aalhamad/irxbot/docs/spec/gearbox/Pasted image.png

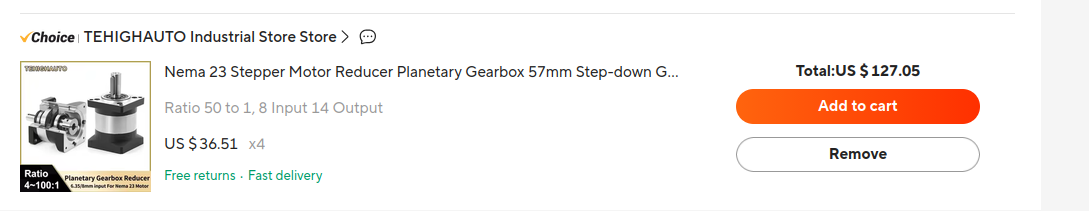
docs/spec/gearbox/Pasted image.png
