aalhamad/irxbot/docs/spec/motor-LK57BL9524/Screenshot from 2026-10-16 10-22-00.png

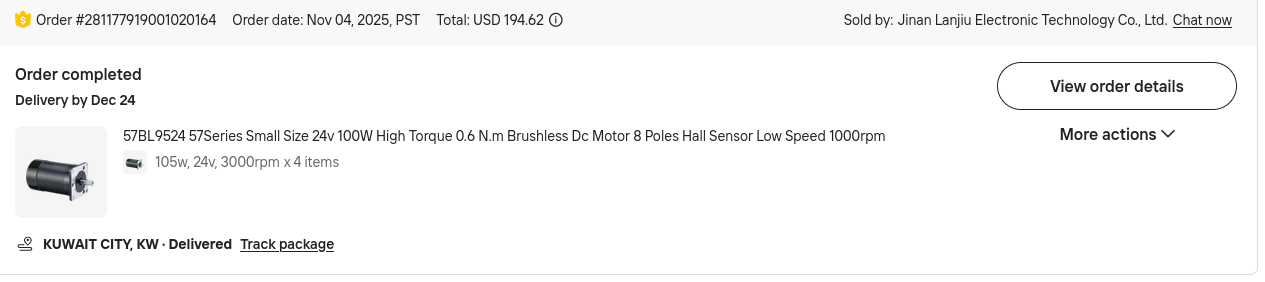
docs/spec/motor-LK57BL9524/Screenshot from 2026-10-16 10-22-00.png
