aalhamad/irxbot/docs/TODO.md

# IRXBot To-Do

## Now

See `docs/hardware-check-plan.md` for the plan and decisions.

### Hardware check and rewiring
- [ ] Compile and flash the `STATUS` firmware (see `docs/workflow.md`)
- [ ] Investigate the check results: invalid ToF readings, VEML7700 failed reads, high dust readings, LiDAR (see `docs/hardware-check-plan.md`)
- [x] ESP-IDF 5.3 is on the Jetson at `~/Apps/esp-idf` (capital A); the ESP32 is built and flashed there
- [ ] Run `scripts/robot_check.py --manual --baseline` and correct it from the first real output
- [ ] Before rewiring, run `robot_check.py --spin` with the wheels up and confirm all 4 wheels turn
- [ ] Check the Waveshare hub's input voltage on its label before powering it
- [ ] Temporary USB layout: Jetson = RealSense, STM32, ESP32, Waveshare hub. Waveshare hub = 4G modem, LiDAR, 360° camera, black 4-port hub. Black hub (unpowered, strap it down, all ports on) = ReSpeaker, thermal adapter
- [ ] When the second Waveshare hub arrives, it replaces the black hub: Waveshare hub 1 = ReSpeaker, 360° camera, LiDAR, hub 2. Hub 2 = thermal adapter, 4G modem
- [ ] Photograph and label the wires
- [ ] Rewire one section at a time, running the check after each: power, CAN, STM32 sensors, ESP32 sensors, USB

## Next

### SIM / 4G (Quectel EC25-EUX), after rewiring
- [ ] Fit SIM and antenna (`MAIN`, plus `DIV` if available)
- [ ] Connect modem to Jetson through the powered USB hub
- [ ] Turn on `ModemManager` and confirm the modem appears in `mmcli -L`
- [ ] Add rules so `ModemManager` ignores the STM32 and ESP32. **Do not drive while it is on without these**
- [ ] Set up the connection (needs carrier APN and SIM PIN status)
- [ ] Decide what it is for: remote access, Foxglove away from Wi-Fi, or internet only

### Audio
- [x] Confirm the ReSpeaker has a 3.5 mm output
- [x] Power the XH-M139 from the 12 V rail through a 5 A fuse, never the raw battery bus
- [x] Wire ReSpeaker to amp to speakers. Leave the subwoofer output empty and never connect a speaker `−` to ground
- [x] Run the record and playback tests on the Jetson (`plughw:ArrayUAC10,0`)
- [ ] Confirm both speakers play: run `speaker-test -D plughw:ArrayUAC10,0 -c 2 -t wav -l 2` and listen to each one
- [ ] Check for motor noise in the speakers and microphone while driving (the audio cable is unshielded)
- [ ] Mount the speakers and amp inside the robot
- [ ] Write the voice command software (none exists yet)

### Cameras
- [ ] 360° camera: connect it, get a picture, set `CAMERA_360_NAME` in `scripts/robot_check.py`
- [ ] Thermal camera: wire it through the USB-serial adapter, get a reading, confirm its data format

### ESP32
- [ ] Flash the LCD IP firmware and rebuild `ros2/` on the Jetson; confirm the LCD shows the IP and telemetry still arrives
- [ ] Install `scripts/irx-esp32-telemetry.service` so the IP shows at boot
- [ ] Reserve a fixed IP for the Jetson in the router
- [ ] Connect the native `USB` port (`303a:1001`) to the Jetson; leave the 5V pin and other USB port empty
- [ ] Power the LED strips from the 5 V rail, not through the ESP32 board
- [x] Set up fixed port names for the STM32 and ESP32 (the nodes find them in `/dev/serial/by-id/`)

### Close up the robot
- [ ] Tug-test the front left VESC CAN connector
- [ ] Strap down the USB cables
- [ ] Confirm the E-stop can be reached with the robot closed
- [ ] Check Wi-Fi signal with the robot closed (`nmcli device wifi list`, `SIGNAL` above about 50)

### Driving
- [ ] Measure the first drive against `/odom` (it reported 3.04 m forward, 0.94 m right): did it really veer?
- [ ] If it veers, find out why the front right wheel is slow to start
- [ ] Confirm the node's single `ERR:CMD_TIMEOUT` was left over from testing and does not repeat

## Later
- [ ] Publish IMU and ToF as ROS2 topics at proper rates (still every 3 s)
- [ ] Reinstall `sllidar_ros2` for the LiDAR
- [ ] Charger indicator with ATtiny
- [ ] Set up SLAM, then Nav2
- [ ] Foxglove for live data, then a custom dashboard if wanted (`docs/hardware-check-plan.md`)
- [ ] Resolve the ToF count: spec says 4 with a downward one, firmware has 5 with none
- [ ] Disable regen below 0 °C for outdoor use
- [ ] Delete `~/irx_fw_diag`, `~/irx_fw_build` (its .bin files were copied to `firmware/stm32/irx_drive/build/`) and `~/irx_test.log` on the Jetson

## Only if needed
- [ ] Wi-Fi upgrade if the signal is weak when closed: try external antennas on the built-in card first, then the AC1200 adapter (kept in the parts box, not in the spec)
