aalhamad/irxbot/docs/spec/motor-LK57BL9524/ZNF60-L2(12-100)14-50-70-M4.pdf

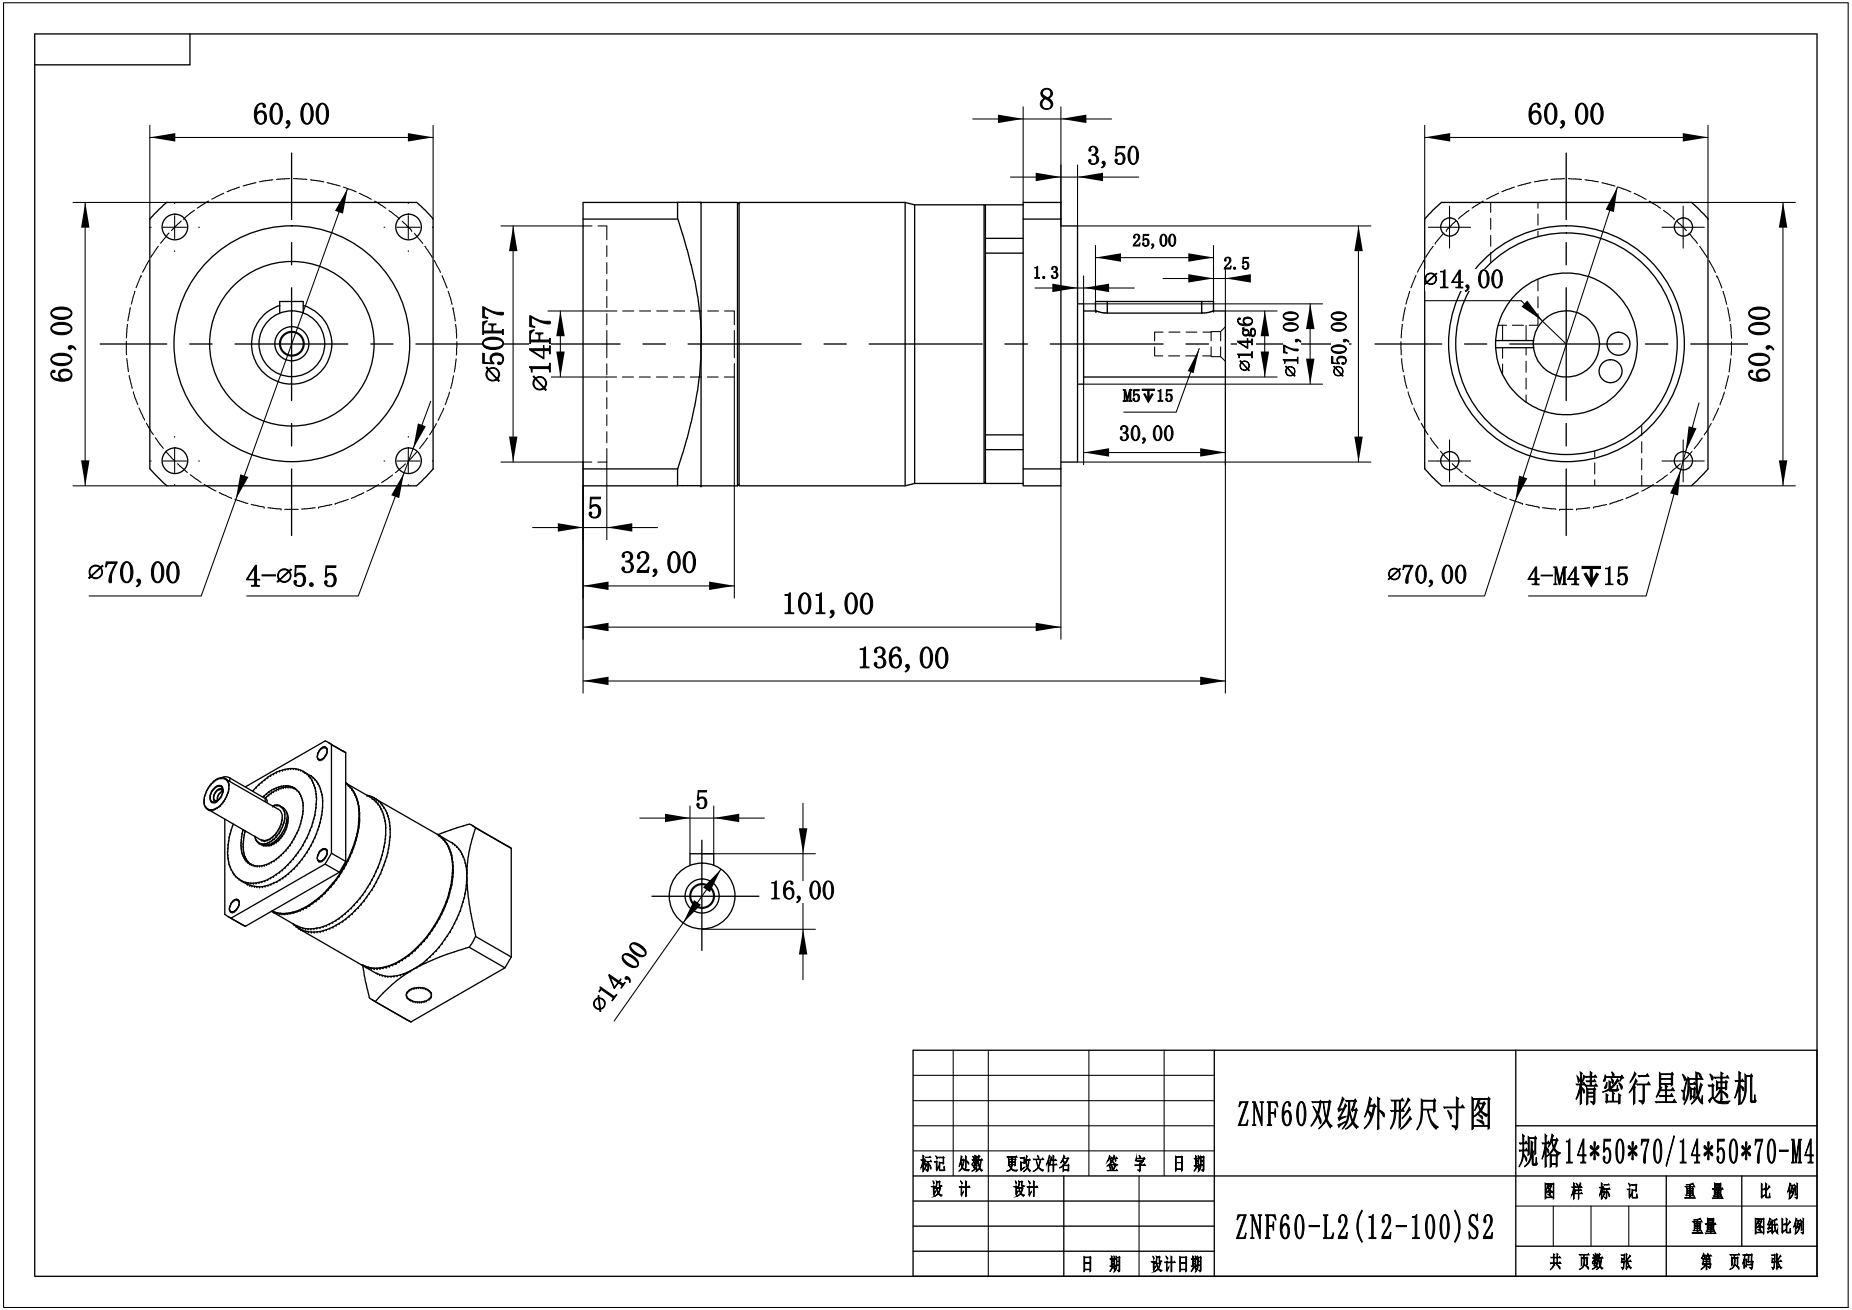
[picture p4: page 1]
