aalhamad/irxbot/docs/spec/motor-LK57BL9524/ZPF60-L2.pdf

型号:

Ø 7 0

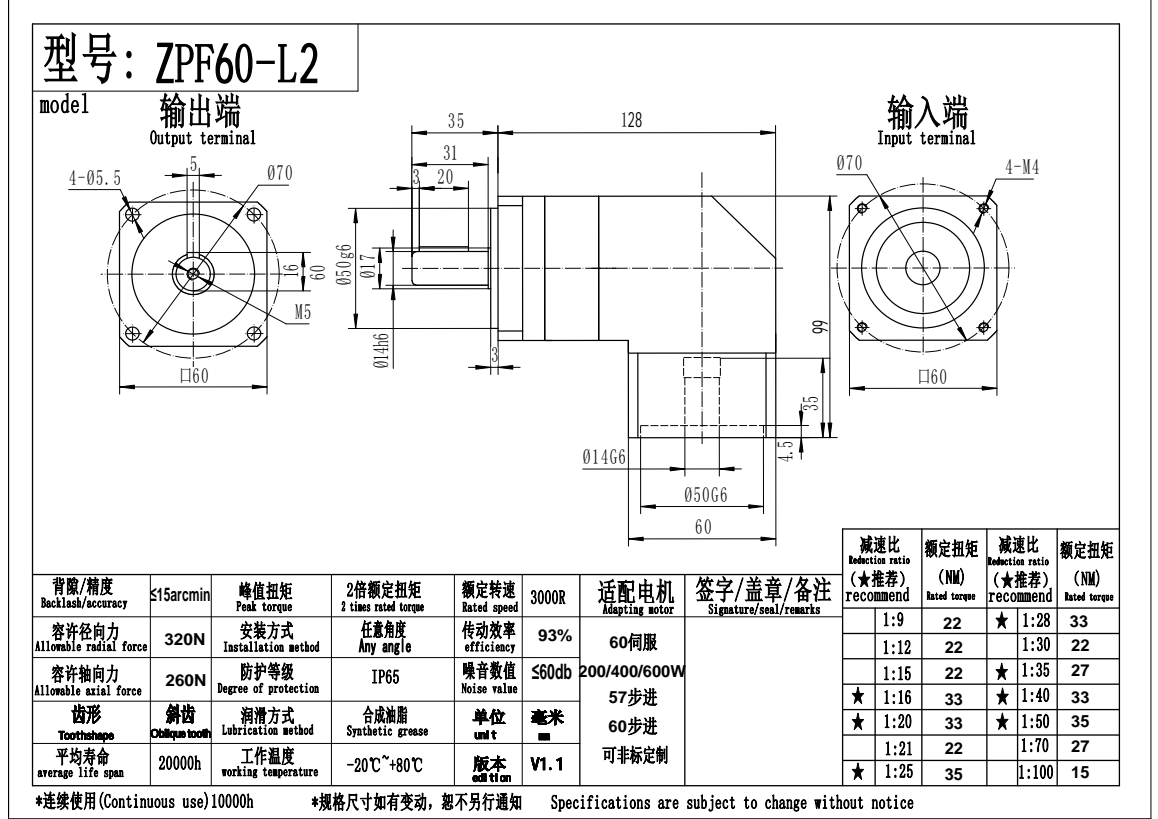
[picture p5: page 1]
ZPF60-L2; 输出端; 输入端

≤15arcmin | | 适配电机 | 签字/盖章/备注

22 | 33
22 | 22

320N | 93% | 60 200/400/600W 57 60
260N | | ≤60db | 22 | 27

33 | 33
33 | 35
22 | 27
35 | 15

齿形 齿形 齿形 齿形 齿形 Toothshape Toothshape Toothshape Toothshape Toothshape | 斜齿 斜齿 斜齿 斜齿 斜齿 Oblique tooth Oblique tooth Oblique tooth Oblique tooth Oblique tooth | 单位 单位 单位 单位 单位 unit unit unit unit unit | 毫米 毫米 毫米 毫米 毫米 mm mm mm mm mm

版本 版本 版本 版本 版本 edition edition edition edition edition | V1.1 V1.1 V1.1 V1.1 V1.1
