aalhamad/irxbot/firmware/stm32/irx_drive/Core/Src/main.c

	/* USER CODE BEGIN Header */
/**
  ******************************************************************************
  * @file           : main.c
  * @brief          : Main program body
  ******************************************************************************
  * @attention
  *
  * Copyright (c) 2026 STMicroelectronics.
  * All rights reserved.
  *
  * This software is licensed under terms that can be found in the LICENSE file
  * in the root directory of this software component.
  * If no LICENSE file comes with this software, it is provided AS-IS.
  *
  ******************************************************************************
  */
/* USER CODE END Header */
/* Includes ------------------------------------------------------------------*/
#include "main.h"

/* USER CODE BEGIN Includes */
#include "bno085.h"
#include "ibus.h"
#include "robot_drive.h"
#include "vl53l1x.h"
#include <stdio.h>
#include <string.h>
#include <stdlib.h>

/* USER CODE END Includes */

/* USER CODE BEGIN PD */
#define CMD_TIMEOUT_MS  1000U   /* stop if the Jetson sends no valid CMD for this long */
#define ODO_PERIOD_MS   50U     /* 20 Hz */
#define SPEED_PERIOD_MS 200U    /* 5 Hz to the ESP32 */

/* USER CODE END PD */

CAN_HandleTypeDef hcan1;

I2C_HandleTypeDef hi2c1;
I2C_HandleTypeDef hi2c2;

UART_HandleTypeDef huart1;
UART_HandleTypeDef huart2;
UART_HandleTypeDef huart3;

/* USER CODE BEGIN PV */
static uint32_t last_imu_tick     = 0;
static uint32_t last_tof_tick     = 0;
static uint32_t last_odo_tick     = 0;
static uint32_t last_speed_tick   = 0;
static uint32_t last_cmd_rx_tick  = 0;
static uint32_t last_err_tick[4]  = {0};
static uint8_t  cmd_buf[32];
static uint8_t  cmd_len           = 0;
static int32_t  cmd_left          = 0;
static int32_t  cmd_right         = 0;
static uint32_t last_cmd_tick     = 0;
static uint8_t  bumper_last       = 0xFF; /* force send on first loop */
static uint8_t  tof_reinit_count  = 0;
static uint32_t tof_reinit_tick   = 0;
static uint32_t horn_off_tick     = 0;  /* 0 = horn inactive */
static uint8_t  rc_override       = 0;

/* USER CODE END PV */

void SystemClock_Config(void);
static void MX_GPIO_Init(void);
static void MX_CAN1_Init(void);
static void MX_USART2_UART_Init(void);
static void MX_I2C1_Init(void);
static void MX_I2C2_Init(void);
static void MX_USART1_UART_Init(void);
static void MX_USART3_UART_Init(void);
/* USER CODE BEGIN 0 */

/* USART2 RX ring buffer: filled by USART2_IRQHandler, drained by the main loop.
 * The loop blocks on I2C for far longer than one byte time (87 us at 115200). */
#define UART2_RX_SIZE 256U   /* uint8_t indices wrap at exactly this size */

static volatile uint8_t uart2_rx[UART2_RX_SIZE];
static volatile uint8_t uart2_rx_head = 0;
static volatile uint8_t uart2_rx_tail = 0;
static volatile uint8_t uart2_rx_lost = 0;

void Uart2_RxByte(uint8_t b)
{
    uint8_t next = (uint8_t)(uart2_rx_head + 1U);
    if (next == uart2_rx_tail)
    {
        uart2_rx_lost = 1;   /* full: the line being received is now corrupt */
        return;
    }
    uart2_rx[uart2_rx_head] = b;
    uart2_rx_head = next;
}

static uint8_t Uart2_RxPop(uint8_t *b)
{
    if (uart2_rx_tail == uart2_rx_head) return 0;
    *b = uart2_rx[uart2_rx_tail];
    uart2_rx_tail = (uint8_t)(uart2_rx_tail + 1U);
    return 1;
}

/* Strict "<left> <right>" parse. A partial number must never become a speed. */
static uint8_t Parse_Cmd(const char *s, int32_t *left, int32_t *right)
{
    char *end;
    long l = strtol(s, &end, 10);
    if (end == s || *end != ' ') return 0;

    const char *r_start = end + 1;
    long r = strtol(r_start, &end, 10);
    if (end == r_start || *end != '\0') return 0;

    if (l < -6000 || l > 6000 || r < -6000 || r > 6000) return 0;

    *left  = (int32_t)l;
    *right = (int32_t)r;
    return 1;
}

/* USER CODE END 0 */

/**
  * @brief  The application entry point.
  * @retval int
  */
int main(void)
{

  /* MCU Configuration--------------------------------------------------------*/

  /* Reset of all peripherals, Initializes the Flash interface and the Systick. */
  HAL_Init();

  /* Configure the system clock */
  SystemClock_Config();

  /* Initialize all configured peripherals */
  MX_GPIO_Init();
  MX_CAN1_Init();
  MX_USART2_UART_Init();
  MX_I2C1_Init();
  MX_I2C2_Init();
  MX_USART1_UART_Init();
  MX_USART3_UART_Init();
  /* USER CODE BEGIN 2 */
  HAL_UART_Transmit(&huart2, (uint8_t*)"BOOT\r\n", 6, 100);

  if (vesc_can_start() != HAL_OK)
      HAL_UART_Transmit(&huart2, (uint8_t*)"ERR:CAN\r\n", 9, 100);
  else
      HAL_UART_Transmit(&huart2, (uint8_t*)"CAN_OK\r\n", 8, 100);

  /* IMU — hardware reset pulse so BNO085 boots clean on every MCU reset */
  HAL_GPIO_WritePin(IMU_RESET_GPIO_Port, IMU_RESET_Pin, GPIO_PIN_RESET);
  HAL_Delay(10);
  HAL_GPIO_WritePin(IMU_RESET_GPIO_Port, IMU_RESET_Pin, GPIO_PIN_SET);
  HAL_Delay(500);

  if (BNO085_Init(&hi2c2) != HAL_OK)
      HAL_UART_Transmit(&huart2, (uint8_t*)"ERR:IMU\r\n", 9, 100);
  else
      HAL_UART_Transmit(&huart2, (uint8_t*)"IMU_OK\r\n", 8, 100);

  /* ToF — retry up to 3 times to handle sensors that are slow to boot */
  {
      uint8_t n = 0;
      for (int attempt = 0; attempt < 5 && n < TOF_COUNT; attempt++)
      {
          if (attempt > 0) HAL_Delay(200);
          n = ToF_InitAll(&hi2c1);
      }
      char buf[32];
      int  len = snprintf(buf, sizeof(buf), "TOF_OK %u/5\r\n", n);
      HAL_UART_Transmit(&huart2, (uint8_t*)buf, len, 100);
  }

  /* RC receiver */
  IBus_Init(&huart1);

  /* IWDG — contactor drops automatically if MCU hangs > ~1.5 s */
  IWDG->KR  = 0x5555U;   /* unlock PR/RLR */
  IWDG->PR  = 3U;         /* prescaler /32 → 32 kHz/32 = 1 kHz tick */
  IWDG->RLR = 1500U;      /* 1500 ticks ≈ 1.5 s */
  IWDG->KR  = 0xCCCCU;   /* start */

  /* Energise contactor */
  HAL_GPIO_WritePin(CONTACTOR_EN_GPIO_Port, CONTACTOR_EN_Pin, GPIO_PIN_SET);
  HAL_UART_Transmit(&huart2, (uint8_t*)"CONTACTOR_ON\r\n", 14, 50);

  /* Jetson commands: enabled last so nothing sent during boot is acted on */
  __HAL_UART_ENABLE_IT(&huart2, UART_IT_RXNE);

  /* USER CODE END 2 */

  /* Infinite loop */
  /* USER CODE BEGIN WHILE */
  while (1)
  {
    /* USER CODE END WHILE */

    /* USER CODE BEGIN 3 */
      IWDG->KR = 0xAAAAU;   /* kick watchdog */
      uint32_t now = HAL_GetTick();

      /* ── IMU ── */
      BNO085_Process();

      /* ── RC receiver ── */
      IBus_Process();
      {
          IBus_Data_t *rc = IBus_Get();

          uint8_t override_now = rc->valid && (rc->channel[IBUS_OVERRIDE_CH] > IBUS_OVERRIDE_THR);

          if (override_now != rc_override)
          {
              rc_override = override_now;
              if (!rc_override)
              {
                  robot_set_rpm(0, 0);
                  cmd_left = cmd_right = 0;
                  last_cmd_tick = 0;
              }
              HAL_UART_Transmit(&huart2,
                  rc_override ? (uint8_t*)"RC_ON\r\n" : (uint8_t*)"RC_OFF\r\n",
                  rc_override ? 7 : 8, 10);
          }

          if (rc_override)
          {
              /* CH2 (index 1) = throttle, CH1 (index 0) = steering */
              int32_t thr = (int32_t)rc->channel[1] - 1500;  /* -500..+500 */
              int32_t str = (int32_t)rc->channel[0] - 1500;

              if (thr > -30 && thr < 30) thr = 0;
              if (str > -30 && str < 30) str = 0;

              static uint32_t rc_cmd_tick = 0;
              if ((now - rc_cmd_tick) >= 50)
              {
                  rc_cmd_tick = now;
                  if (thr != 0 || str != 0)
                  {
                      int32_t left_rpm  = (thr + str) * 6000 / 500;
                      int32_t right_rpm = (thr - str) * 6000 / 500;
                      robot_set_rpm(left_rpm, right_rpm);
                  }
              }
          }
      }

      /* ── ToF ── */
      ToF_Process();

      /* ── ToF drop recovery: re-init if any sensor offline, max 5 attempts ── */
      if (tof_reinit_count < 5 && (now - tof_reinit_tick) >= 3000)
      {
          uint8_t any_offline = 0;
          for (int i = 0; i < TOF_COUNT; i++)
              if (!ToF_Get(i)->online) { any_offline = 1; break; }
          if (any_offline)
          {
              tof_reinit_tick = now;
              tof_reinit_count++;
              ToF_InitAll(&hi2c1);
          }
      }

      /* ── UART RX: accumulate CMD <left> <right> ── */
      uint8_t b;
      while (Uart2_RxPop(&b))
      {
          if (b == '\n' || b == '\r')
          {
              if (cmd_len == 0) continue;   /* ignore empty / duplicate CR+LF */
              cmd_buf[cmd_len] = '\0';
              if (uart2_rx_lost)
              {
                  /* Bytes were dropped, so this line can't be trusted */
                  uart2_rx_lost = 0;
                  HAL_UART_Transmit(&huart2, (uint8_t*)"ERR:CMD\r\n", 9, 50);
              }
              else if (cmd_len == 3 && memcmp(cmd_buf, "CAN", 3) == 0)
              {
                  vesc_can_dump_status();
              }
              else if (cmd_len == 6 && memcmp(cmd_buf, "STATUS", 6) == 0)
              {
                  /* Hardware check: ms since each VESC was heard (-1 = never), online ToF mask */
                  long age[4];
                  for (uint8_t id = 1; id <= 4; id++)
                  {
                      uint32_t last = vesc_last_seen(id);
                      age[id-1] = (last == 0) ? -1 : (long)(HAL_GetTick() - last);
                  }
                  uint8_t tof_mask = 0;
                  for (int i = 0; i < TOF_COUNT; i++)
                      if (ToF_Get(i)->online) tof_mask |= (uint8_t)(1U << i);
                  char st[80];
                  int sn = snprintf(st, sizeof(st),
                      "STATUS VESC:%ld,%ld,%ld,%ld TOF:%u IMU:%u RC:%u BMP:%u\r\n",
                      age[0], age[1], age[2], age[3], tof_mask,
                      BNO085_GetData()->valid, IBus_Get()->valid, bumper_last);
                  HAL_UART_Transmit(&huart2, (uint8_t*)st, sn, 50);
              }
              else if (cmd_len >= 6 &&
                  cmd_buf[0]=='H' && cmd_buf[1]=='O' &&
                  cmd_buf[2]=='R' && cmd_buf[3]=='N' && cmd_buf[4]==' ')
              {
                  uint32_t ms = (uint32_t)strtol((char*)cmd_buf + 5, NULL, 10);
                  if (ms > 0 && ms <= 5000)
                  {
                      HAL_GPIO_WritePin(HORN_GPIO_Port, HORN_Pin, GPIO_PIN_SET);
                      horn_off_tick = now + ms;
                  }
                  HAL_UART_Transmit(&huart2, (uint8_t*)"HORN_OK\r\n", 9, 50);
              }
              else if (cmd_len >= 7 &&
                  cmd_buf[0]=='C' && cmd_buf[1]=='M' &&
                  cmd_buf[2]=='D' && cmd_buf[3]==' ')
              {
                  int32_t l, r;
                  if (Parse_Cmd((char*)cmd_buf + 4, &l, &r))
                  {
                      char ack[32];
                      int an = snprintf(ack, sizeof(ack), "CMD_OK %ld %ld\r\n", l, r);
                      HAL_UART_Transmit(&huart2, (uint8_t*)ack, an, 50);

                      cmd_left  = l;
                      cmd_right = r;
                      last_cmd_tick = now;
                      last_cmd_rx_tick = now;
                      robot_set_rpm(l, r);
                  }
                  else
                  {
                      HAL_UART_Transmit(&huart2, (uint8_t*)"ERR:CMD\r\n", 9, 50);
                  }
              }
              else if (cmd_len >= 6 &&
                  cmd_buf[0]=='L' && cmd_buf[1]=='I' &&
                  cmd_buf[2]=='G' && cmd_buf[3]=='H' &&
                  cmd_buf[4]=='T' && cmd_buf[5]==' ')
              {
                  HAL_UART_Transmit(&huart3, cmd_buf, cmd_len, 50);
                  HAL_UART_Transmit(&huart3, (uint8_t*)"\n", 1, 10);
                  HAL_UART_Transmit(&huart2, (uint8_t*)"LIGHT_OK\r\n", 10, 50);
              }
              else
              {
                  HAL_UART_Transmit(&huart2, (uint8_t*)"ERR:CMD\r\n", 9, 50);
              }
              cmd_len = 0;
          }
          else if (cmd_len < (uint8_t)(sizeof(cmd_buf) - 1))
          {
              cmd_buf[cmd_len++] = b;
          }
      }

      /* ── Horn auto-off ── */
      if (horn_off_tick > 0 && now >= horn_off_tick)
      {
          HAL_GPIO_WritePin(HORN_GPIO_Port, HORN_Pin, GPIO_PIN_RESET);
          horn_off_tick = 0;
      }

      /* ── Jetson link lost: the resend below would otherwise run the motors forever ── */
      if (last_cmd_tick > 0 && (now - last_cmd_rx_tick) > CMD_TIMEOUT_MS)
      {
          if (!rc_override) robot_set_rpm(0, 0);
          cmd_left = cmd_right = 0;
          last_cmd_tick = 0;
          HAL_UART_Transmit(&huart2, (uint8_t*)"ERR:CMD_TIMEOUT\r\n", 17, 50);
      }

      /* ── Periodic CMD resend @ 200 ms — keeps VESCs alive within their 1s timeout ── */
      if (last_cmd_tick > 0 && (now - last_cmd_tick) >= 200)
      {
          last_cmd_tick = now;
          robot_set_rpm(cmd_left, cmd_right);
      }

      /* ── ToF report @ 500 ms ── */
      if ((now - last_tof_tick) >= 3000)
      {
          last_tof_tick = now;
          char buf[80];
          int n = snprintf(buf, sizeof(buf),
              "TOF FL:%u FR:%u L:%u R:%u REAR:%u\r\n",
              ToF_Get(TOF_FRONT_LEFT)->distance_mm,
              ToF_Get(TOF_FRONT_RIGHT)->distance_mm,
              ToF_Get(TOF_LEFT)->distance_mm,
              ToF_Get(TOF_RIGHT)->distance_mm,
              ToF_Get(TOF_REAR)->distance_mm);
          HAL_UART_Transmit(&huart2, (uint8_t*)buf, n, 20);
      }

      /* ── IMU report @ 10 s (debug rate) ── */
      if ((now - last_imu_tick) >= 3000)
      {
          last_imu_tick = now;
          BNO085_Data_t *imu = BNO085_GetData();
          if (imu->valid)
          {
              char buf[128];
              int n = snprintf(buf, sizeof(buf),
                  "IMU %.4f %.4f %.4f %.4f %.4f %.4f %.4f %.4f %.4f %.4f\r\n",
                  imu->qw, imu->qx, imu->qy, imu->qz,
                  imu->ax, imu->ay, imu->az,
                  imu->gx, imu->gy, imu->gz);
              HAL_UART_Transmit(&huart2, (uint8_t*)buf, n, 10);
          }
      }

      /* ── Bumpers: send BMP on any change ── */
      {
          uint8_t bmp = 0;
          if (HAL_GPIO_ReadPin(BUMPER_FL_GPIO_Port, BUMPER_FL_Pin) == GPIO_PIN_SET) bmp |= 1;
          if (HAL_GPIO_ReadPin(BUMPER_FR_GPIO_Port, BUMPER_FR_Pin) == GPIO_PIN_SET) bmp |= 2;
          if (HAL_GPIO_ReadPin(BUMPER_RL_GPIO_Port, BUMPER_RL_Pin) == GPIO_PIN_SET) bmp |= 4;
          if (HAL_GPIO_ReadPin(BUMPER_RR_GPIO_Port, BUMPER_RR_Pin) == GPIO_PIN_SET) bmp |= 8;
          if (bmp != bumper_last)
          {
              bumper_last = bmp;
              char buf[24];
              int n = snprintf(buf, sizeof(buf), "BMP %u %u %u %u\r\n",
                  (bmp >> 0) & 1,
                  (bmp >> 1) & 1,
                  (bmp >> 2) & 1,
                  (bmp >> 3) & 1);
              HAL_UART_Transmit(&huart2, (uint8_t*)buf, n, 10);
              HAL_UART_Transmit(&huart3, (uint8_t*)buf, n, 10);

              const char *lmsg = (bmp != 0)
                  ? "LIGHT ALL 255 0 0 BLINK\n"
                  : "LIGHT ALL 0 0 0 SOLID\n";
              HAL_UART_Transmit(&huart3, (uint8_t*)lmsg, strlen(lmsg), 50);
          }
      }

      /* ── ODO report @ 20 Hz ── */
      if ((now - last_odo_tick) >= ODO_PERIOD_MS)
      {
          last_odo_tick = now;

          int32_t l_rpm = 0, r_rpm = 0;
          vesc_get_rpm(VESC_FL, &l_rpm);
          vesc_get_rpm(VESC_FR, &r_rpm);

          char buf[32];
          int n = snprintf(buf, sizeof(buf), "ODO %ld %ld\r\n", l_rpm, r_rpm);
          HAL_UART_Transmit(&huart2, (uint8_t*)buf, n, 10);

          if ((now - last_speed_tick) >= SPEED_PERIOD_MS)
          {
              last_speed_tick = now;
              int32_t avg_rpm = (l_rpm + r_rpm) / 2;
              int sn = snprintf(buf, sizeof(buf), "SPEED %ld\n", avg_rpm);
              HAL_UART_Transmit(&huart3, (uint8_t*)buf, sn, 10);
          }

          /* Report any VESC that has stopped responding (rate-limited to 1 per 2 s) */
          for (uint8_t id = 1; id <= 4; id++)
          {
              uint32_t last = vesc_last_seen(id);
              if (last == 0) continue;  /* never heard — VESC may not be powered */
              /* Read the tick after `last`: `now` is from the top of the loop, so
               * a frame received since then would make (now - last) wrap around
               * and report a healthy VESC as silent. */
              if ((HAL_GetTick() - last) > 1000 && (now - last_err_tick[id-1]) > 2000)
              {
                  last_err_tick[id-1] = now;
                  char err[16];
                  int en = snprintf(err, sizeof(err), "ERR:ODO%d\r\n", id);
                  HAL_UART_Transmit(&huart2, (uint8_t*)err, en, 50);
              }
          }
      }

}
  /* USER CODE END 3 */
}

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
