aalhamad/irxbot/firmware/stm32/irx_drive/Core/Inc/main.h

#define B1_Pin GPIO_PIN_13
#define B1_GPIO_Port GPIOC
#define BUMPER_FL_Pin GPIO_PIN_0
#define BUMPER_FL_GPIO_Port GPIOC
#define BUMPER_FR_Pin GPIO_PIN_1
#define BUMPER_FR_GPIO_Port GPIOC
#define BUMPER_RL_Pin GPIO_PIN_2
#define BUMPER_RL_GPIO_Port GPIOC
#define BUMPER_RR_Pin GPIO_PIN_3
#define BUMPER_RR_GPIO_Port GPIOC
#define USART_TX_Pin GPIO_PIN_2
#define USART_TX_GPIO_Port GPIOA
#define USART_RX_Pin GPIO_PIN_3
#define USART_RX_GPIO_Port GPIOA
#define LD2_Pin GPIO_PIN_5
#define LD2_GPIO_Port GPIOA
#define TOF_XSHUT_FRONT_Pin GPIO_PIN_0
#define TOF_XSHUT_FRONT_GPIO_Port GPIOB
#define CONTACTOR_EN_Pin GPIO_PIN_12
#define CONTACTOR_EN_GPIO_Port GPIOB
#define HORN_Pin GPIO_PIN_6
#define HORN_GPIO_Port GPIOC
#define TOF_XSHUT_LEFT_Pin GPIO_PIN_7
#define TOF_XSHUT_LEFT_GPIO_Port GPIOC
#define IMU_RESET_Pin GPIO_PIN_8
#define IMU_RESET_GPIO_Port GPIOC
#define TOF5_XSHUT_Pin GPIO_PIN_9
#define TOF5_XSHUT_GPIO_Port GPIOC
#define TOF_XSHUT_REAR_Pin GPIO_PIN_8
#define TOF_XSHUT_REAR_GPIO_Port GPIOA
#define TMS_Pin GPIO_PIN_13
#define TMS_GPIO_Port GPIOA
#define TCK_Pin GPIO_PIN_14
#define TCK_GPIO_Port GPIOA
#define SWO_Pin GPIO_PIN_3
#define SWO_GPIO_Port GPIOB
#define TOF_XSHUT_RIGHT_Pin GPIO_PIN_6
#define TOF_XSHUT_RIGHT_GPIO_Port GPIOB
