aalhamad/irxbot/firmware/esp32/irxbot_esp32/main/irxbot_esp32.c

#include "task_uart.h"
#include "task_lighting.h"
#include "task_sensors.h"
#include "task_telemetry.h"
#include "task_alarm.h"
#include "task_display.h"

void app_main(void)
{
    task_uart_start();
    task_lighting_start();
    task_sensors_start();
    task_telemetry_start();
    task_alarm_start();
    task_display_start();
}
