aalhamad/irxbot/(commit log)

2026-03-29 feat: add irx_driver ROS2 C++ node with cmd_vel to motor control
2026-03-30 feat: add odometry publisher to motor driver node
2026-06-10 STM32: BNO085 IMU streaming, CAN motors working
2026-07-21 finished esp32
2026-10-16 working on motors
2026-10-18 stm32 v1
2026-10-23 finished stm32
2026-10-31 esp32 sensors
2026-10-31 esp32 confirmed
2026-11-01 Fix lost serial commands and false VESC errors
    The main loop polled USART2 once per pass, after blocking I2C work, so all
    but the first byte of a CMD was overrun and full-speed commands got no reply.
    Receive by interrupt into a ring buffer instead.
    - Validate CMD strictly: reject partial or out-of-range values, and any line
    that lost bytes, rather than treating a missing speed as 0.
    - Accept only VESC status frames on CAN and drain the FIFO by interrupt.
    - Fix ERR:ODO false alarms: comparing a frame time against the tick from the
    top of the loop wrapped around and reported healthy VESCs as silent.
    - Stop dumping CAN status and blocking 5 ms on every CMD; send "CAN" instead.
    - irx_driver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
2026-11-01 Stop motors on lost commands and report ODO at 20 Hz
    The STM32 resends the last CMD indefinitely, so a crashed node or Jetson left
    the wheels turning. Stop the motors and send ERR:CMD_TIMEOUT when no valid CMD
    arrives for 1 s.
    Raise ODO from every 10 s to 20 Hz so /odom is usable. SPEED to the ESP32 goes
    to 5 Hz rather than following ODO.
    Claude-Session: https://claude.ai/code/session_01RP82NyJnYaBz8EXmQYhkdZ
2026-11-01 Add robot hardware check and record plan
    scripts/robot_check.py checks each part in the spec from the Jetson and
    never sends CMD. A new STM32 STATUS command reports each VESC, ToF, IMU,
    RC and bumper state for it. The firmware change is not yet compiled.
    Remove UWB, GNSS and the gamepad from the spec, record the camera and hub
    models, and document the check, rewiring and dashboard plan.
    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
2026-11-01 Add STM32 build and flash script
    Builds without CubeIDE and flashes from the Jetson, stopping before the
    flash if the build fails, the image is too small or the port is busy.
    Replaces the deploy.sh instructions in CLAUDE.md.
    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
2026-11-01 Show Jetson IP on the ESP32 LCD and add workflow scripts
    The telemetry node sends the Jetson's IP over USB every 5 s and the LCD
    shows it in place of the gas voltage. USB now carries only telemetry and
    these lines; ESP32 logs stay on UART0. The ESP32 change is not yet compiled.
    Add flash_esp32.sh, build_ros2.sh and a boot service, lower the flash_stm32
    size limit that rejected a good build, and document the workflow and the
    first hardware check results.
    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
2026-11-01 Retry STATUS in the hardware check
    The STM32 answered CAN but not the first STATUS after opening the port, so
    the VESCs showed as not tested. Also record the second run's results.
    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
2026-11-01 Stop treating invalid ToF readings as failures
    The firmware reports 0 for any invalid reading, so one 0 does not mean a
    sensor failed. FAIL now means offline or no reading; partly valid sensors
    warn. The hand test also ignores invalid readings.
    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
2026-11-01 Add wheel spin option to the hardware check
    robot_check.py --spin runs the wheels instead of the checks, after asking
    for confirmation, within ERPM and time limits, and stops on exit or Ctrl+C.
    Without --spin the script still cannot move the motors.
    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
2026-11-02 Add wiring pinout PDF for reassembly
    Pins, USB layout and voltages for the Jetson, STM32 and ESP32, taken
    from the firmware.
    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
2026-11-02 Remove V+ labels from the wiring pinout
    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
2026-11-03 Let the hardware check run one board at a time
    --only stm32, esp32 or jetson, or several. A partial --baseline keeps
    the saved results of the boards not checked.
    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
2026-11-03 Build the STM32 firmware inside the project
    flash_stm32.sh now builds in firmware/stm32/irx_drive/build/, next to the
    ESP32 build, and copies the old ~/irx_fw_build .bin files there once.
    TODO: install ESP-IDF on the Jetson, where the ESP32 is now built.
    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
2026-11-03 Find ESP-IDF at ~/Apps/esp-idf on the Jetson
    ESP-IDF 5.3.2 was already installed there; the script only looked in
    ~/apps. IDF_PATH also works.
    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
2026-11-03 Use the real divider ratios for the 12 V and 5 V rails
    The old 7.55 and 2.73 matched mixed-up wiring, now corrected. Also
    name the ESP32's USB and UART ports in CLAUDE.md.
    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
2026-11-03 Add a monitor option to the ESP32 flash script
    --monitor watches the debug logs if the UART port is plugged in,
    otherwise the sensor data on the USB port.
    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
2026-11-04 Stop showing old DS18B20 temperatures after a failed read
    Each sensor is read on its own; one that fails shows -127 in telemetry
    and -- on the LCD, and the others keep updating.
    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
2026-11-04 Find DS18B20 sensors again without restarting the ESP32
    The bus was scanned only at boot, so a sensor connected or powered later
    was never read. It is now rescanned whenever a sensor is missing or a
    read fails, and each sensor's ROM code is logged.
    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
2026-11-04 Rotate air temperature, humidity and pressure on the LCD
    The BME280 row shows each for 3 s.
    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
2026-11-04 Remove the MQ-2 gas sensor from the robot
    Drops it from the ESP32 firmware, LCD, buzzer alarm, ROS2 telemetry node,
    hardware check, docs and wiring PDF. GPIO 1 is free. The LCD's bottom bar
    now shows only the Jetson IP, and the buzzer stays off.
    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
2026-11-05 Reopen the DS18B20 1-Wire bus after a failed read
    A timed-out read left the RMT receiver stuck, so every later read failed
    with "channel not in enable state" until the ESP32 restarted. The bus is
    now closed and reopened after any failed read.
    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
2026-11-05 Find the STM32 and ESP32 by USB name instead of ttyACM number
    ttyACM0 and ttyACM1 swap between reboots, so the motor node could open the
    ESP32. Both nodes now default to serial_port=auto and look in
    /dev/serial/by-id; flash_stm32.sh checks the STM32 port the same way.
    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
2026-11-05 Bring back the MQ-2 and undo the DS18B20 bus reopen
    Reverts ec0d606 and 505de5f. The ESP32 firmware is back to b779061; the
    fixed USB port names from 65199bf stay.
    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
2026-11-05 Read the DS18B20s with software 1-Wire, like the Arduino library
    ESP-IDF's RMT 1-Wire driver can't hold the data line high during a
    conversion, so sensors on parasite power reset mid-reading. The new code
    detects parasite power and drives the line high while they measure, checks
    the scratchpad CRC, and logs which sensor runs on parasite power.
    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
2026-11-05 Remove the MQ-2 gas sensor from the robot again
    Re-applies 505de5f on top of the software 1-Wire DS18B20 code. The ESP32
    firmware, LCD, buzzer alarm, ROS2 telemetry node, hardware check, docs and
    wiring PDF no longer have the MQ-2; GPIO 1 is free.
    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
2026-11-05 Report I2C addresses and DS18B20s found on the ESP32's USB port
    After each ENV line the ESP32 now sends 'I2C <addresses>' and
    'OW bat=<rom> rear=<rom> front=<rom>' (':parasite' when a sensor's VDD is
    not connected), so wiring faults show up without the UART cable.
    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
2026-11-05 Wait at least 20 ms for the SGP30 measurement
    A 20 ms vTaskDelay is 2 ticks at 100 Hz and can end after just over 10 ms,
    before the SGP30's 12 ms measurement, so about 1 read in 10 failed.
    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
2026-11-05 Look again every minute for I2C sensors that are missing or failing
    Sensors were only searched for at boot, so one loose at startup stayed
    missing until RST. Every 60 s, any sensor not found or with 3 failed reads
    in a row is started again, after dropping its old bus handle.
    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
